Timothy-Kowalski/CrazyFlie-Notes/Crazyflie-Images/Crazyflie_ESP32_2.jpg

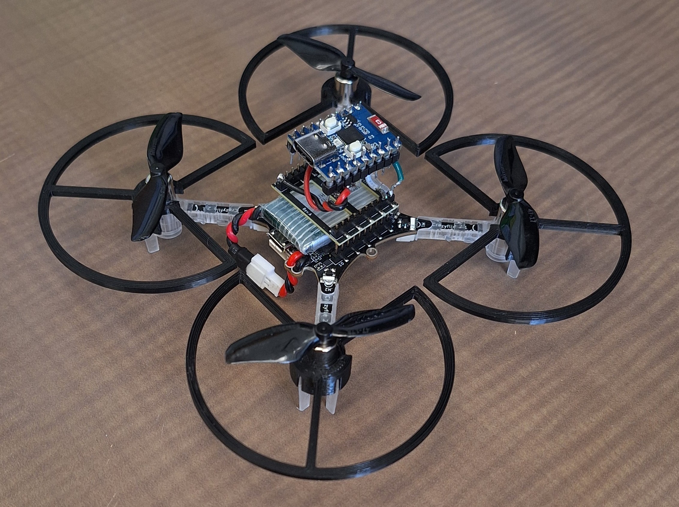
Crazyflie-Images/Crazyflie_ESP32_2.jpg
