Timothy-Kowalski/CrazyFlie-Notes/Crazyflie-Images/Crazyflie_ESP32_1.jpg

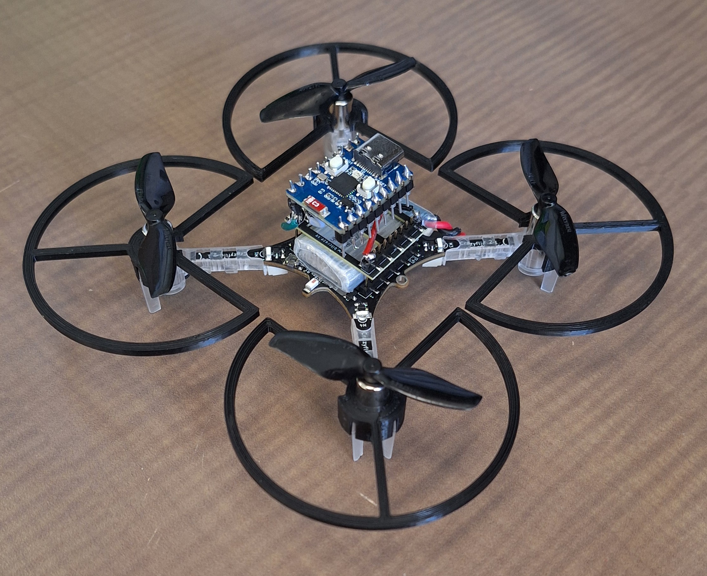
Crazyflie-Images/Crazyflie_ESP32_1.jpg
