Timothy-Kowalski/CrazyFlie-Notes/Prop_Guard_Redesign_1.SLDPRT

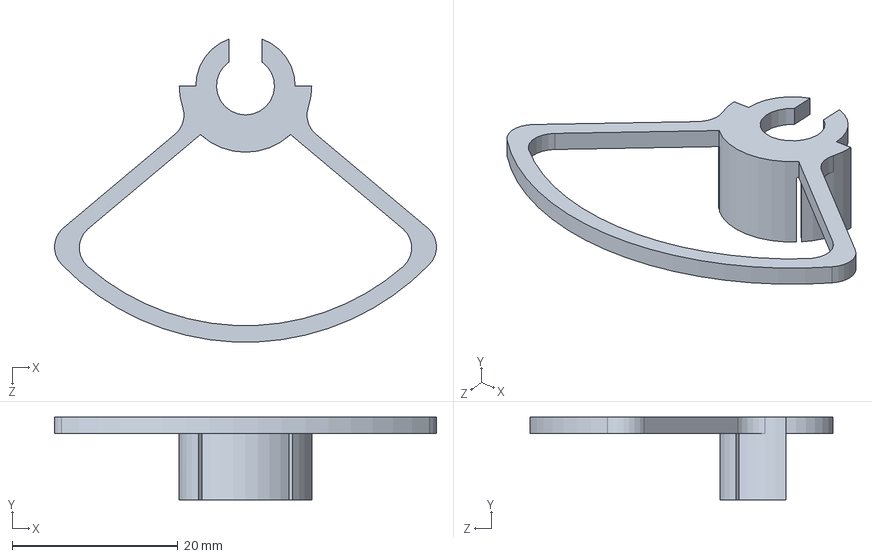
[picture p3: CAD file, 2025-05-27]
Prop_Guard_Redesign_1.SLDPRT
46.1 x 10.0 x 36.6 mm
