Timothy-Kowalski/CrazyFlie-Notes/(list of files, cad)

Other CAD files:
Prop_Guard_Redesign_1.STL
