Timothy-Kowalski/CrazyFlie-Notes/ESP_32_proj.pdf

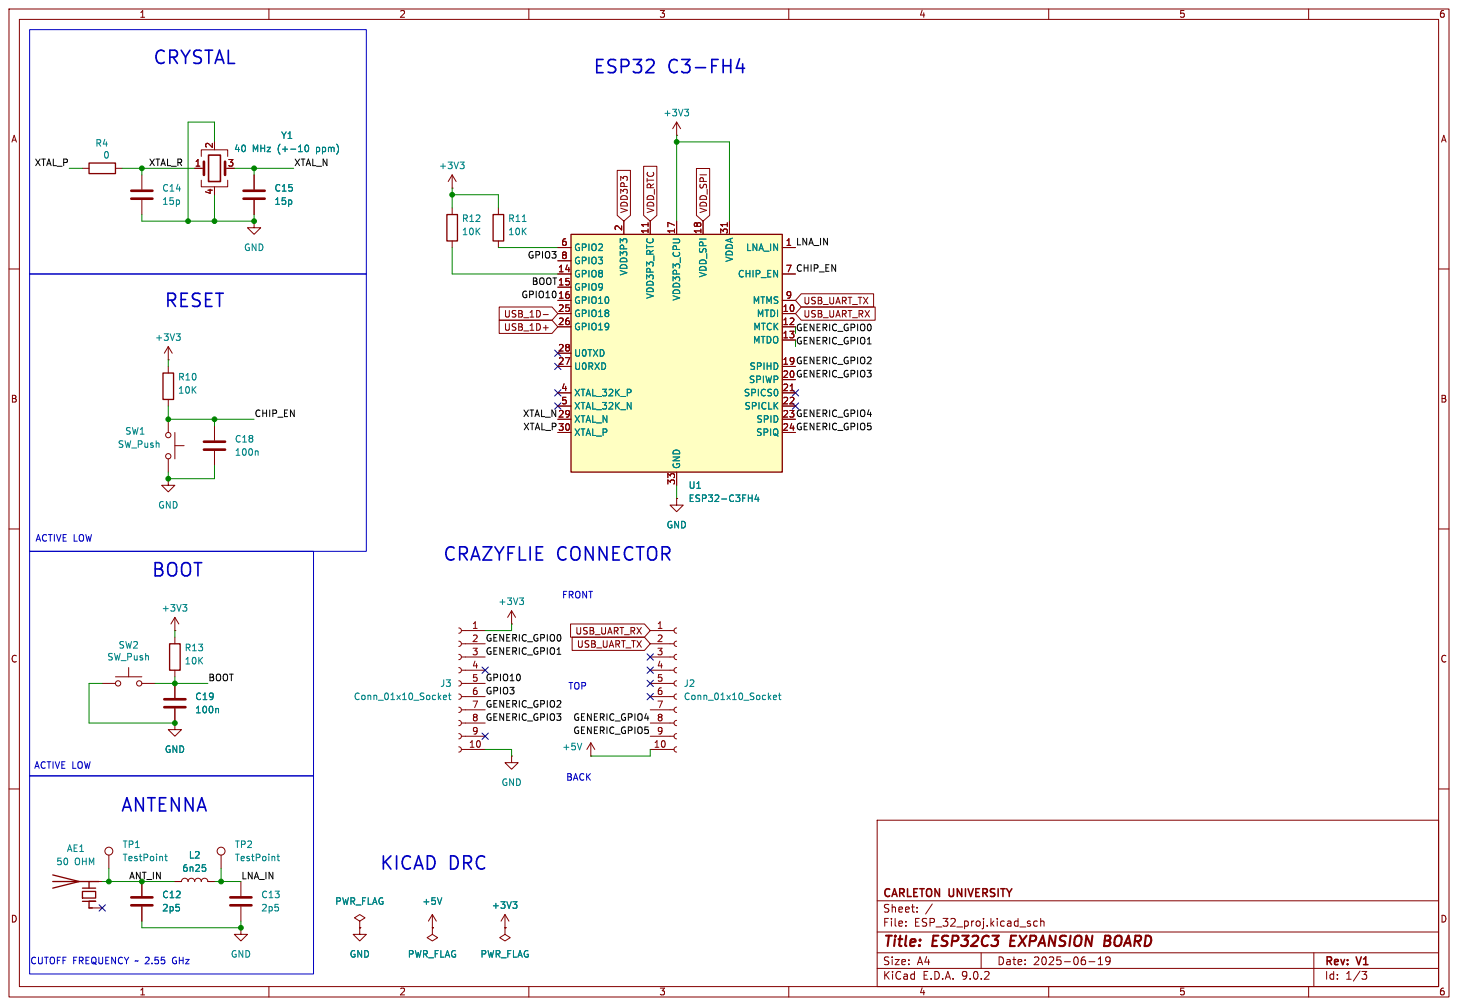
[picture p4: page 1]

File: ESP_32_proj.kicad_sch Sheet: / CARLETON UNIVERSITY

Id: 1/3 Title: ESP32C3 EXPANSION BOARD

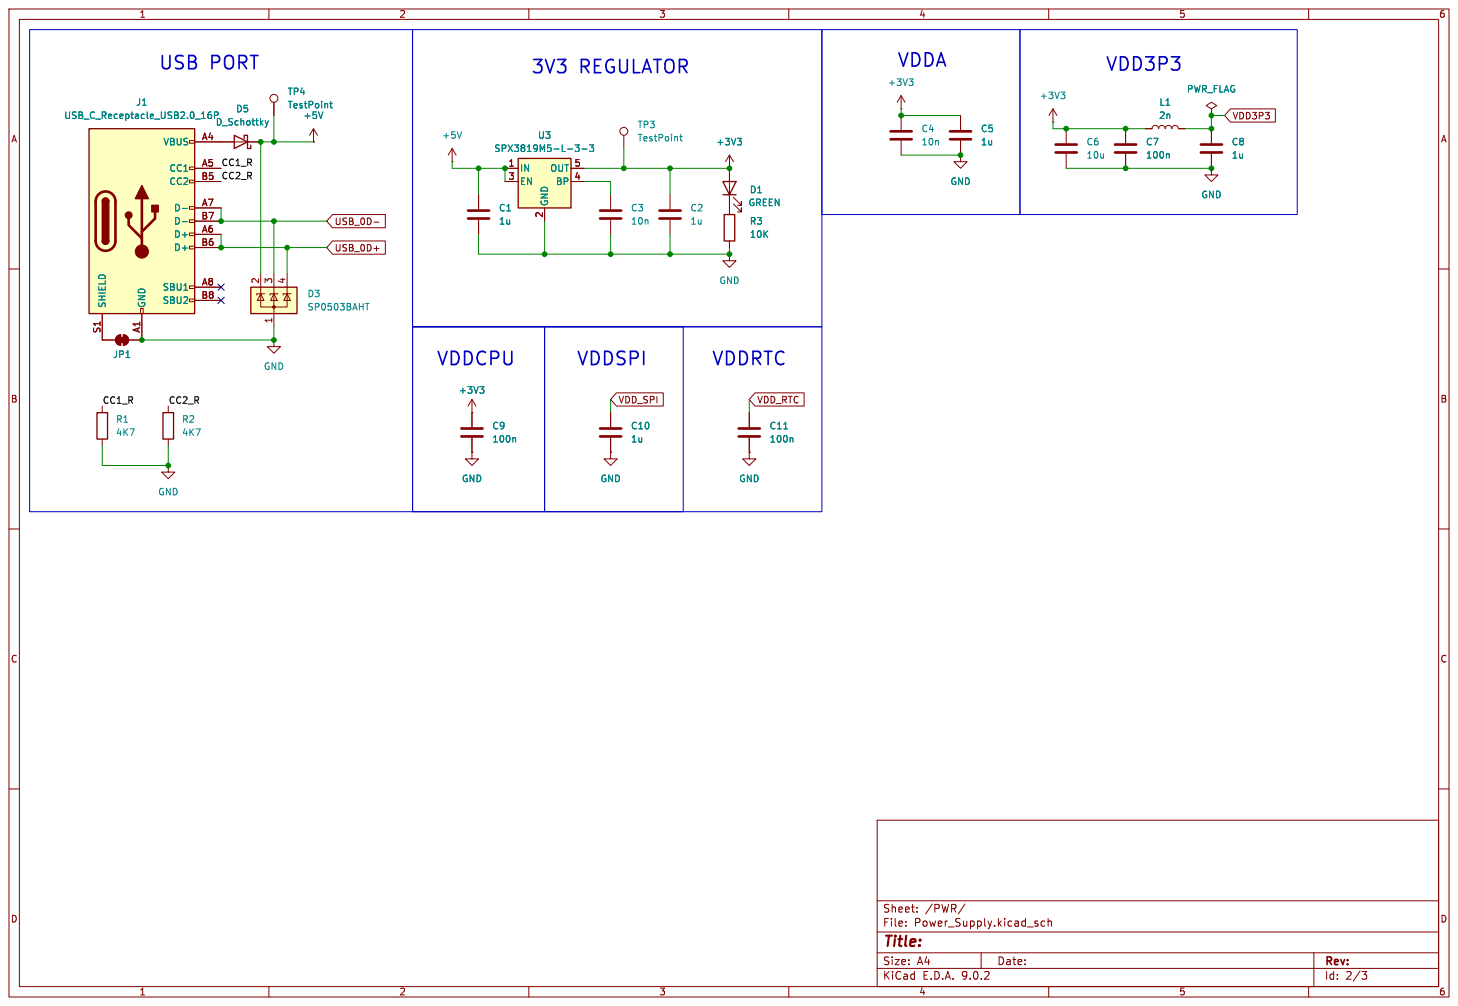
[picture p5: page 2]

2 OUT 5 BP 4 U3 SPX3819M5-L-3-3 TP3 TestPoint D1 GREEN
U3 SPX3819M5-L-3-3

2 OUT 5 BP 4 D1 GREEN GND

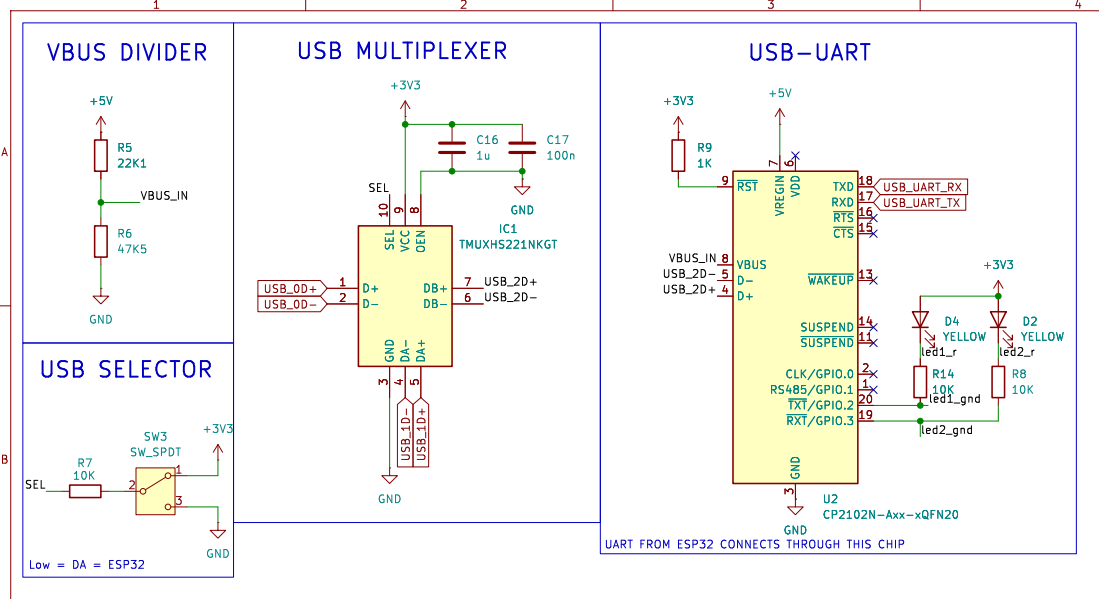
[picture p6: page 3]

UART FROM ESP32 CONNECTS THROUGH THIS CHIP VBUS DIVIDER

3 TXD 18 RXD 17 ~{RTS} 16 ~{CTS} 15 ~{WAKEUP} 13 SUSPEND 14 ~{SUSPEND}11 CLK/GPIO.0 2 RS485/GPIO.1 1 ~{TXT}/GPIO.220 ~{RXT}/GPIO.319 U2 CP2102N-Axx-xQFN20 +3V3 GND

3 TXD 18 RXD 17 ~{RTS} 16 ~{CTS} 15 ~{WAKEUP} 13 SUSPEND 14 ~{SUSPEND}11 CLK/GPIO.0 2 RS485/GPIO.1 1 ~{TXT}/GPIO.220 ~{RXT}/GPIO.319 GND

Low = DA = ESP32 USB SELECTOR

Id: 3/3 Title: File: USB_TO_SERIAL.kicad_sch Sheet: /USB_TO_SERIAL/
