Timothy-Kowalski/CrazyFlie-Notes/ESP_32_proj.kicad_sch

## KiCad design ESP_32_proj.kicad_sch (2025-06-25)

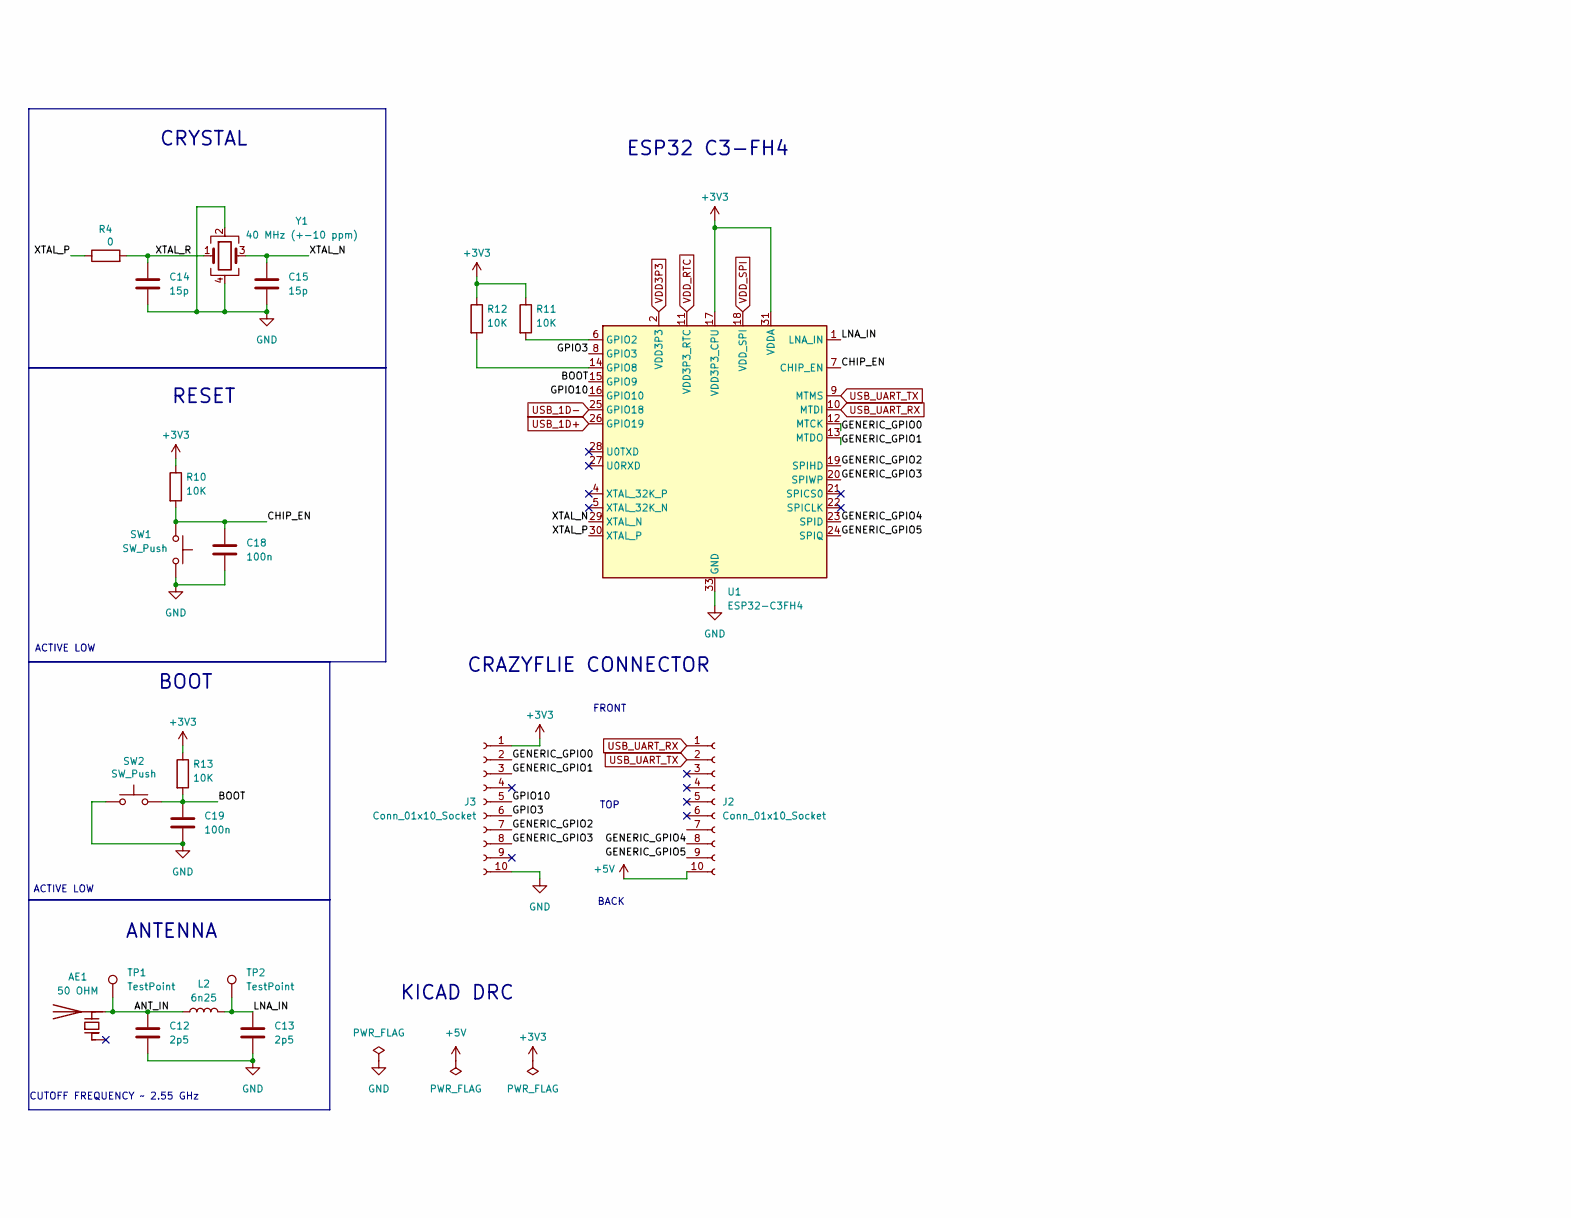
[picture p7: schematic ESP_32_proj.kicad_sch, part in row 1, column 1]

Parts:
AE1: 50 OHM; ANT3216LL00R2400A
C12, C13: 2p5; C_0402_1005Metric
C14, C15: 15p; C_0402_1005Metric
C18, C19: 100n; C_0402_1005Metric
J2, J3: Conn_01x10_Socket; bf090
L2: 6n25; L_0402_1005Metric
R4: 0; C_0603_1608Metric
R10, R11, R12, R13: 10K; R_0402_1005Metric
SW1, SW2: SW_Push; SW_Push_1P1T_NO_CK_KMR2
TP1, TP2: TestPoint; TestPoint_Pad_D1.0mm
U1: ESP32-C3FH4; QFN-32-1EP_5x5mm_P0.5mm_EP3.7x3.7mm
Y1: 40 MHz (+-10 ppm); Crystal_SMD_2520-4Pin_2.5x2.0mm

Connections:
+3V3: J3.1, R10.1, R11.1, R12.1, R13.1, U1.17 (VDD3P3_CPU), U1.31 (VDDA), U1.32 (VDDA)
+5V: J2.10
ANT_IN: AE1.2 (PCB_Trace), C12.1, L2.1, TP1.1
BOOT: C19.1, R13.2, SW2.2, U1.15 (GPIO9)
CHIP_EN: C18.1, R10.2, SW1.1, U1.7 (CHIP_EN)
GENERIC_GPIO0: J3.2, U1.12 (MTCK)
GENERIC_GPIO1: J3.3, U1.13 (MTDO)
GENERIC_GPIO2: J3.7, U1.19 (SPIHD)
GENERIC_GPIO3: J3.8, U1.20 (SPIWP)
GENERIC_GPIO4: J2.8, U1.23 (SPID)
GENERIC_GPIO5: J2.9, U1.24 (SPIQ)
GND: C12.2, C13.2, C14.2, C15.2, C18.2, C19.2, J3.10, SW1.2, SW2.1, U1.33 (GND), Y1.2, Y1.4
GPIO3: J3.6, U1.8 (GPIO3)
GPIO10: J3.5, U1.16 (GPIO10)
LNA_IN: C13.1, L2.2, TP2.1, U1.1 (LNA_IN)
unnamed: R11.2, U1.6 (GPIO2)
unnamed: R12.2, U1.14 (GPIO8)
USB_1D+: U1.26 (GPIO19)
USB_1D-: U1.25 (GPIO18)
USB_UART_RX: J2.1, U1.10 (MTDI)
USB_UART_TX: J2.2, U1.9 (MTMS)
VDD3P3: U1.2 (VDD3P3), U1.3 (VDD3P3)
VDD_RTC: U1.11 (VDD3P3_RTC)
VDD_SPI: U1.18 (VDD_SPI)
XTAL_N: C15.1, U1.29 (XTAL_N), Y1.3
XTAL_P: R4.1, U1.30 (XTAL_P)
XTAL_R: C14.1, R4.2, Y1.1

Notes on the sheet:
FRONT
BOOT
BACK
CRAZYFLIE CONNECTOR
TOP
ACTIVE LOW
RESET
ESP32 C3-FH4
ANTENNA
CUTOFF FREQUENCY ~ 2.55 GHz
CRYSTAL
KICAD DRC
