Timothy-Kowalski/CrazyFlie-Notes/Power_Supply.kicad_sch

## KiCad design Power_Supply.kicad_sch (2025-06-25)

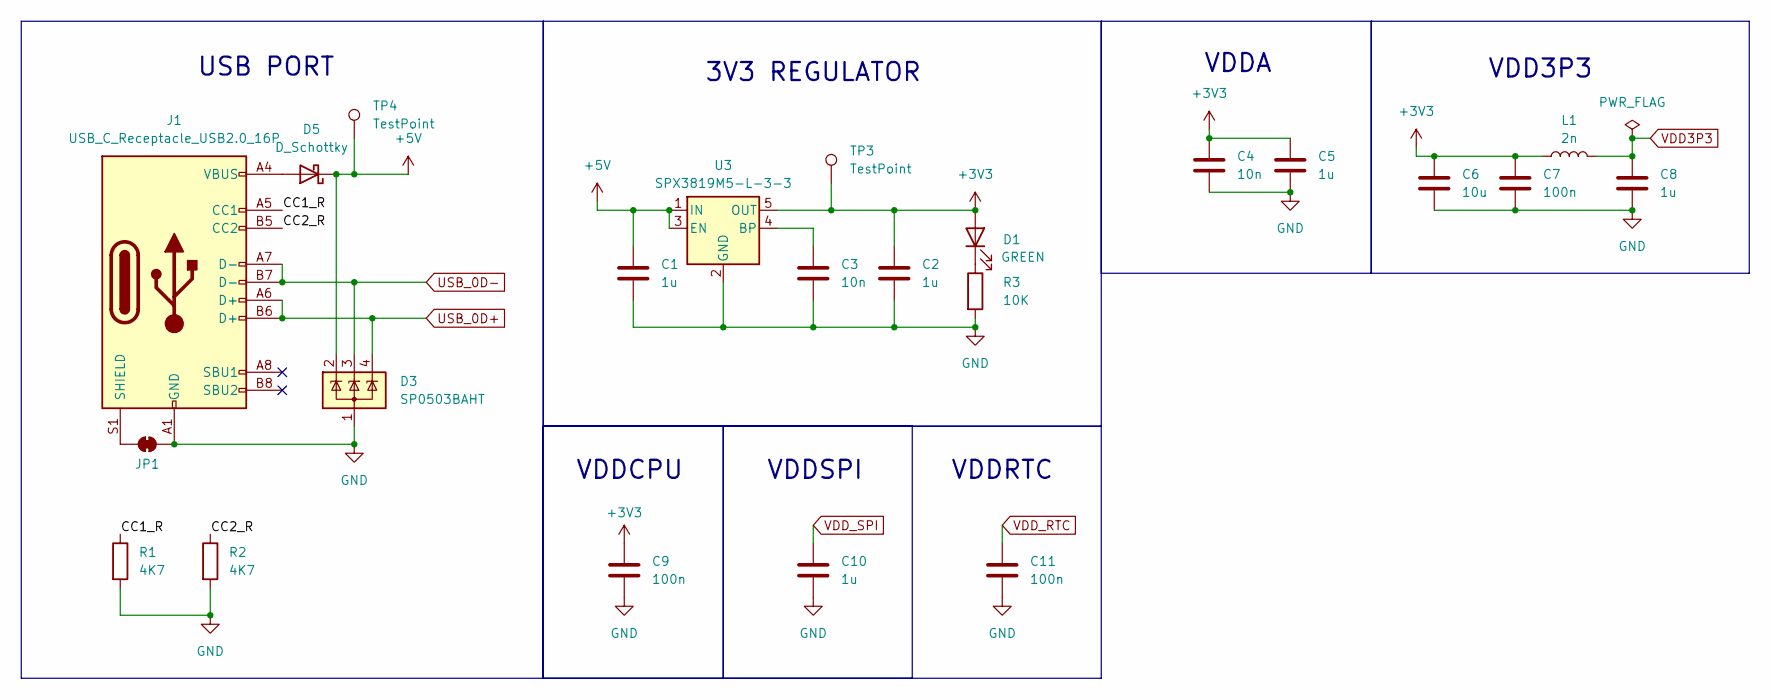
[picture p8: schematic Power_Supply.kicad_sch]

Parts:
C1, C2, C5, C8, C10: 1u; C_0402_1005Metric
C3, C4: 10n; C_0402_1005Metric
C6: 10u; C_0402_1005Metric
C7, C9, C11: 100n; C_0402_1005Metric
D1: GREEN; LED_0402_1005Metric
D3: SP0503BAHT; SOT-143
D5: D_Schottky; D_0402_1005Metric
J1: USB_C_Receptacle_USB2.0_16P; USB_C_Receptacle_GCT_USB4105-xx-A_16P_TopMnt_Horizontal
JP1: SolderJumper_2_Bridged; SolderJumper-2_P1.3mm_Bridged2Bar_RoundedPad1.0x1.5mm
L1: 2n; L_0402_1005Metric
R1, R2: 4K7; R_0402_1005Metric
R3: 10K; R_0402_1005Metric
TP3, TP4: TestPoint; TestPoint_Pad_D1.0mm
U3: SPX3819M5-L-3-3; SOT-23-5

Connections:
+3V3: C2.1, C4.1, C5.1, C6.1, C7.1, C9.1, D1.2 (A), L1.1, TP3.1, U3.5 (OUT)
+5V: C1.1, D3.2 (K), D5.1 (K), TP4.1, U3.1 (IN), U3.3 (EN)
CC1_R: J1.A5 (CC1), R1.1
CC2_R: J1.B5 (CC2), R2.1
GND: C1.2, C2.2, C3.2, C4.2, C5.2, C6.2, C7.2, C8.2, C9.2, C10.2, C11.2, D3.1 (A), J1.A1 (GND), J1.A12 (GND), J1.B1 (GND), J1.B12 (GND), JP1.2 (B), R1.2, R2.2, R3.2, U3.2 (GND)
unnamed: C3.1, U3.4 (BP)
unnamed: D1.1 (K), R3.1
unnamed: D5.2 (A), J1.A4 (VBUS), J1.A9 (VBUS), J1.B4 (VBUS), J1.B9 (VBUS)
unnamed: J1.S1 (SHIELD), JP1.1 (A)
USB_0D+: D3.4 (K), J1.A6 (D+), J1.B6 (D+)
USB_0D-: D3.3 (K), J1.A7 (D-), J1.B7 (D-)
VDD3P3: C8.1, L1.2
VDD_RTC: C11.1
VDD_SPI: C10.1

Notes on the sheet:
USB PORT
VDD3P3
VDDRTC
3V3 REGULATOR
VDDSPI
VDDA
VDDCPU
