Timothy-Kowalski/CrazyFlie-Notes/USB_TO_SERIAL.kicad_sch

## KiCad design USB_TO_SERIAL.kicad_sch (2025-06-25)

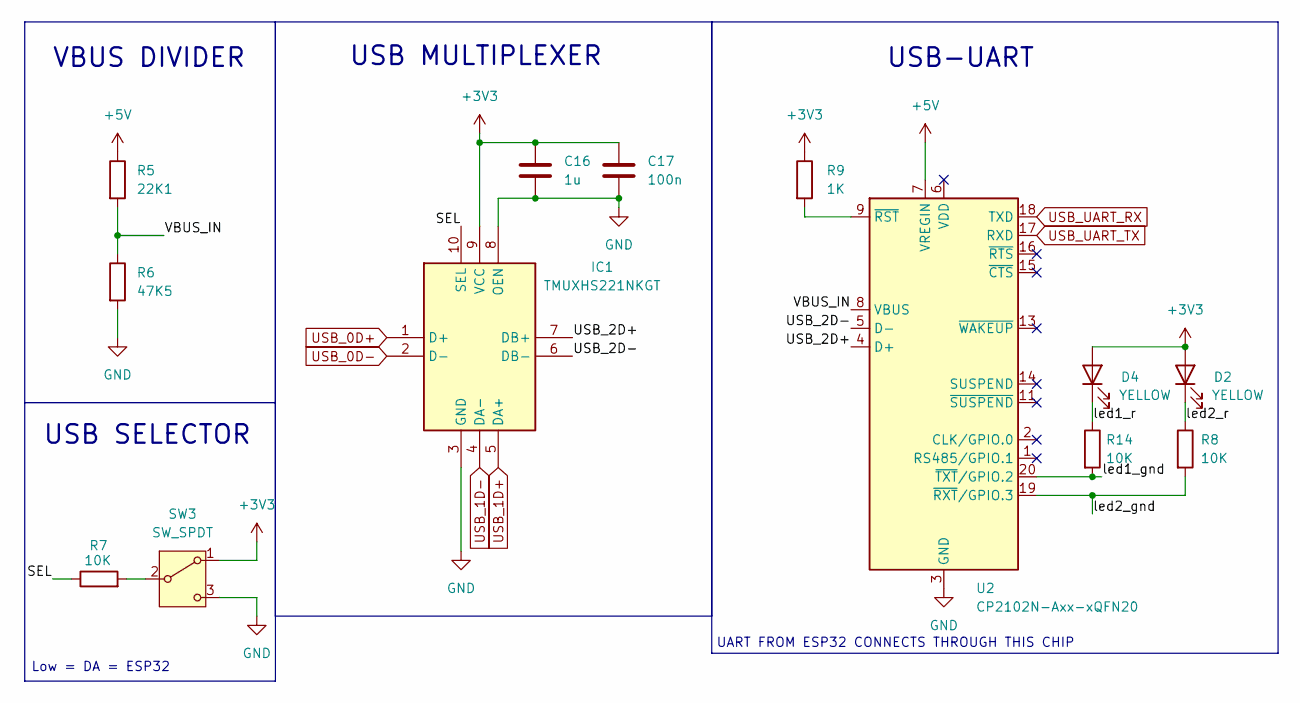
[picture p9: schematic USB_TO_SERIAL.kicad_sch]

Parts:
C16: 1u; C_0402_1005Metric
C17: 100n; C_0402_1005Metric
D2, D4: YELLOW; LED_0402_1005Metric
IC1: TMUXHS221NKGT; Mouser Part Number 595-TMUXHS221NKGT
R5: 22K1; R_0402_1005Metric
R6: 47K5; R_0402_1005Metric
R7, R8, R14: 10K; R_0402_1005Metric
R9: 1K; R_0402_1005Metric
SW3: SW_SPDT; SW_SPDT_PCM12
U2: CP2102N-Axx-xQFN20; QFN-20-1EP_3x3mm_P0.4mm_EP1.65x1.65mm

Connections:
+3V3: C16.1, C17.1, D2.2 (A), D4.2 (A), IC1.9 (VCC), R9.1, SW3.1 (A)
+5V: R5.1, U2.7 (VREGIN)
GND: C16.2, C17.2, IC1.3 (GND), IC1.8 (OEN), R6.2, SW3.3 (C), U2.3 (GND), U2.12 (GND), U2.21 (GND)
unnamed: R7.2, SW3.2 (B)
unnamed: R9.2, U2.9 (~RST)
SEL: IC1.10 (SEL), R7.1
USB_0D+: IC1.1 (D+)
USB_0D-: IC1.2 (D-)
USB_1D+: IC1.5 (DA+)
USB_1D-: IC1.4 (DA-)
USB_2D+: IC1.7 (DB+), U2.4 (D+)
USB_2D-: IC1.6 (DB-), U2.5 (D-)
USB_UART_RX: U2.18 (TXD)
USB_UART_TX: U2.17 (RXD)
VBUS_IN: R5.2, R6.1, U2.8 (VBUS)
led1_gnd: R14.2, U2.20 (~TXT/GPIO.2)
led1_r: D4.1 (K), R14.1
led2_gnd: R8.2, U2.19 (~RXT/GPIO.3)
led2_r: D2.1 (K), R8.1

Notes on the sheet:
VBUS DIVIDER
USB-UART
USB SELECTOR
UART FROM ESP32 CONNECTS THROUGH THIS CHIP
Low = DA = ESP32
USB MULTIPLEXER
